KendaroDuong/imu-breakout-board/Breakout_Board/Breakoutboard_Project_log_missing3Dmodels.txt

[('J3', 'C:\\Program Files\\KiCad\\10.0\\share\\kicad\\3dmodels\\Connector_Hirose.3dshapes\\Hirose_DF11-12DP-2DSA_2x06_P2.00mm_Vertical.step')]
