KendaroDuong/imu-breakout-board/Breakout_Board/Schematic_V1.txt

Plotted to 'C:\Users\Nicos.000\Documents\School program\SeniorDesign\imu-breakout-board\Breakout_Board\Breakoutboard_Project.pdf'.

Info: Done.
