KendaroDuong/imu-breakout-board/Breakout_Board/Breakoutboard_Project.pdf

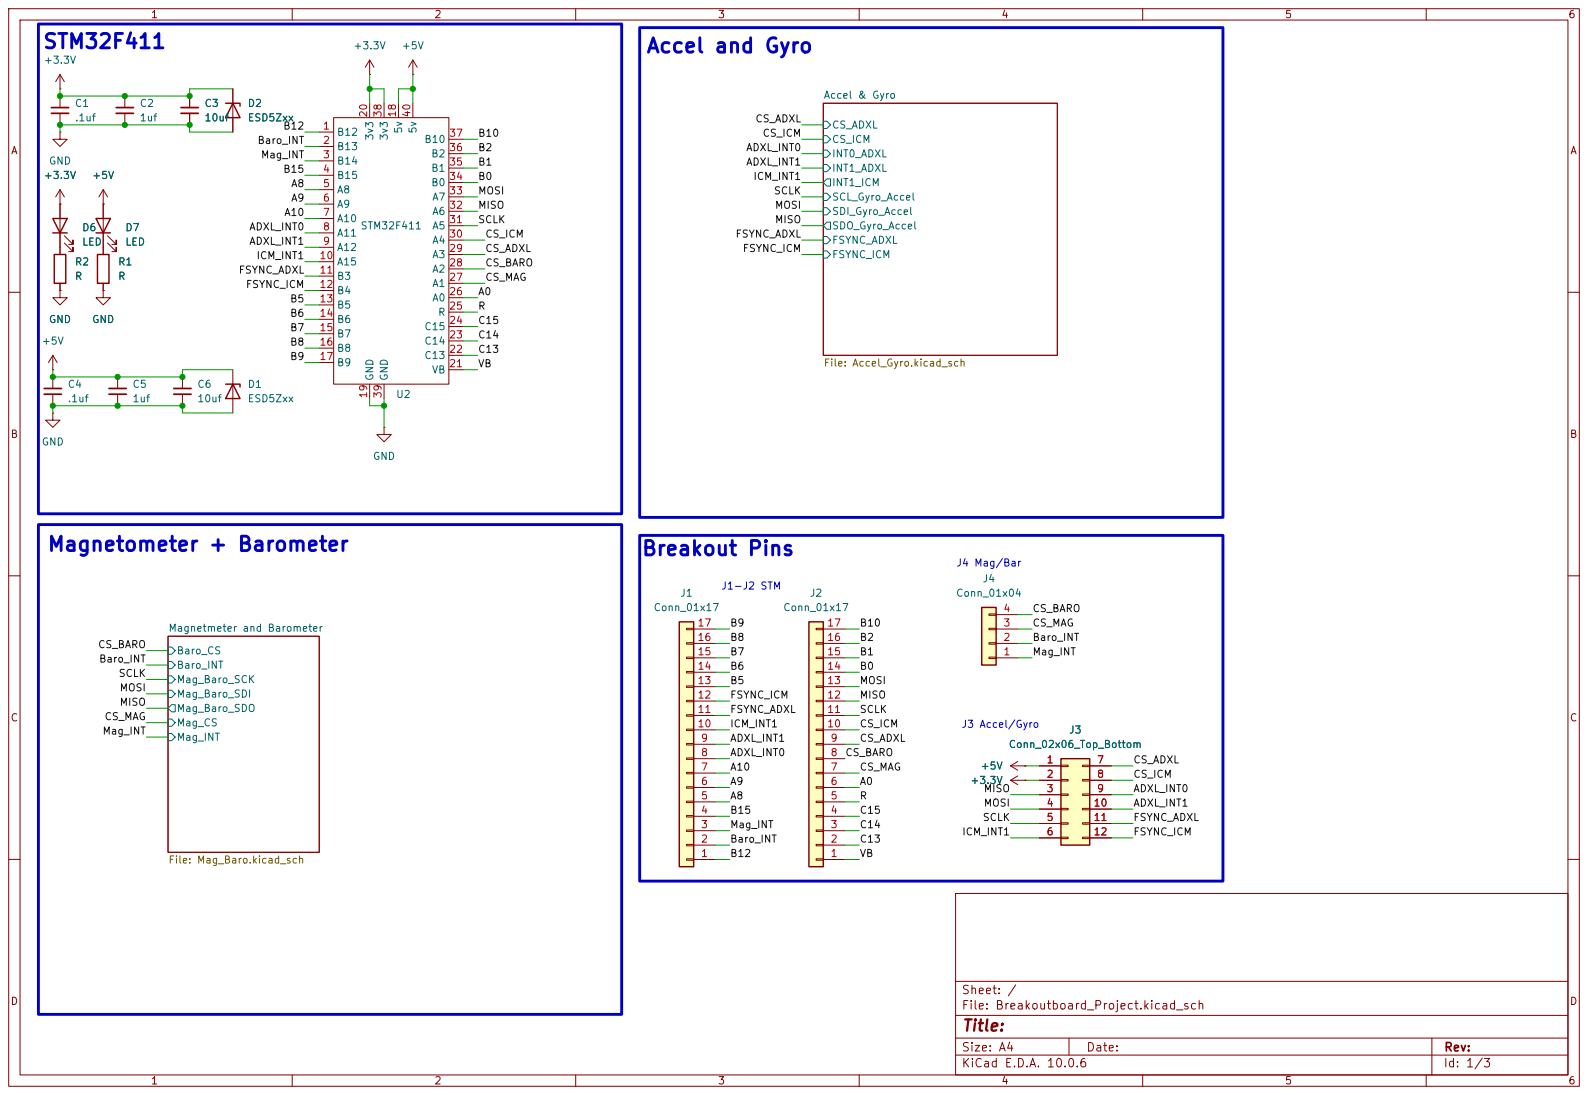
[picture p1: page 1]

Size: A4 | Rev:
KiCad E.D.A. 10.0.6 | Id: 1/3

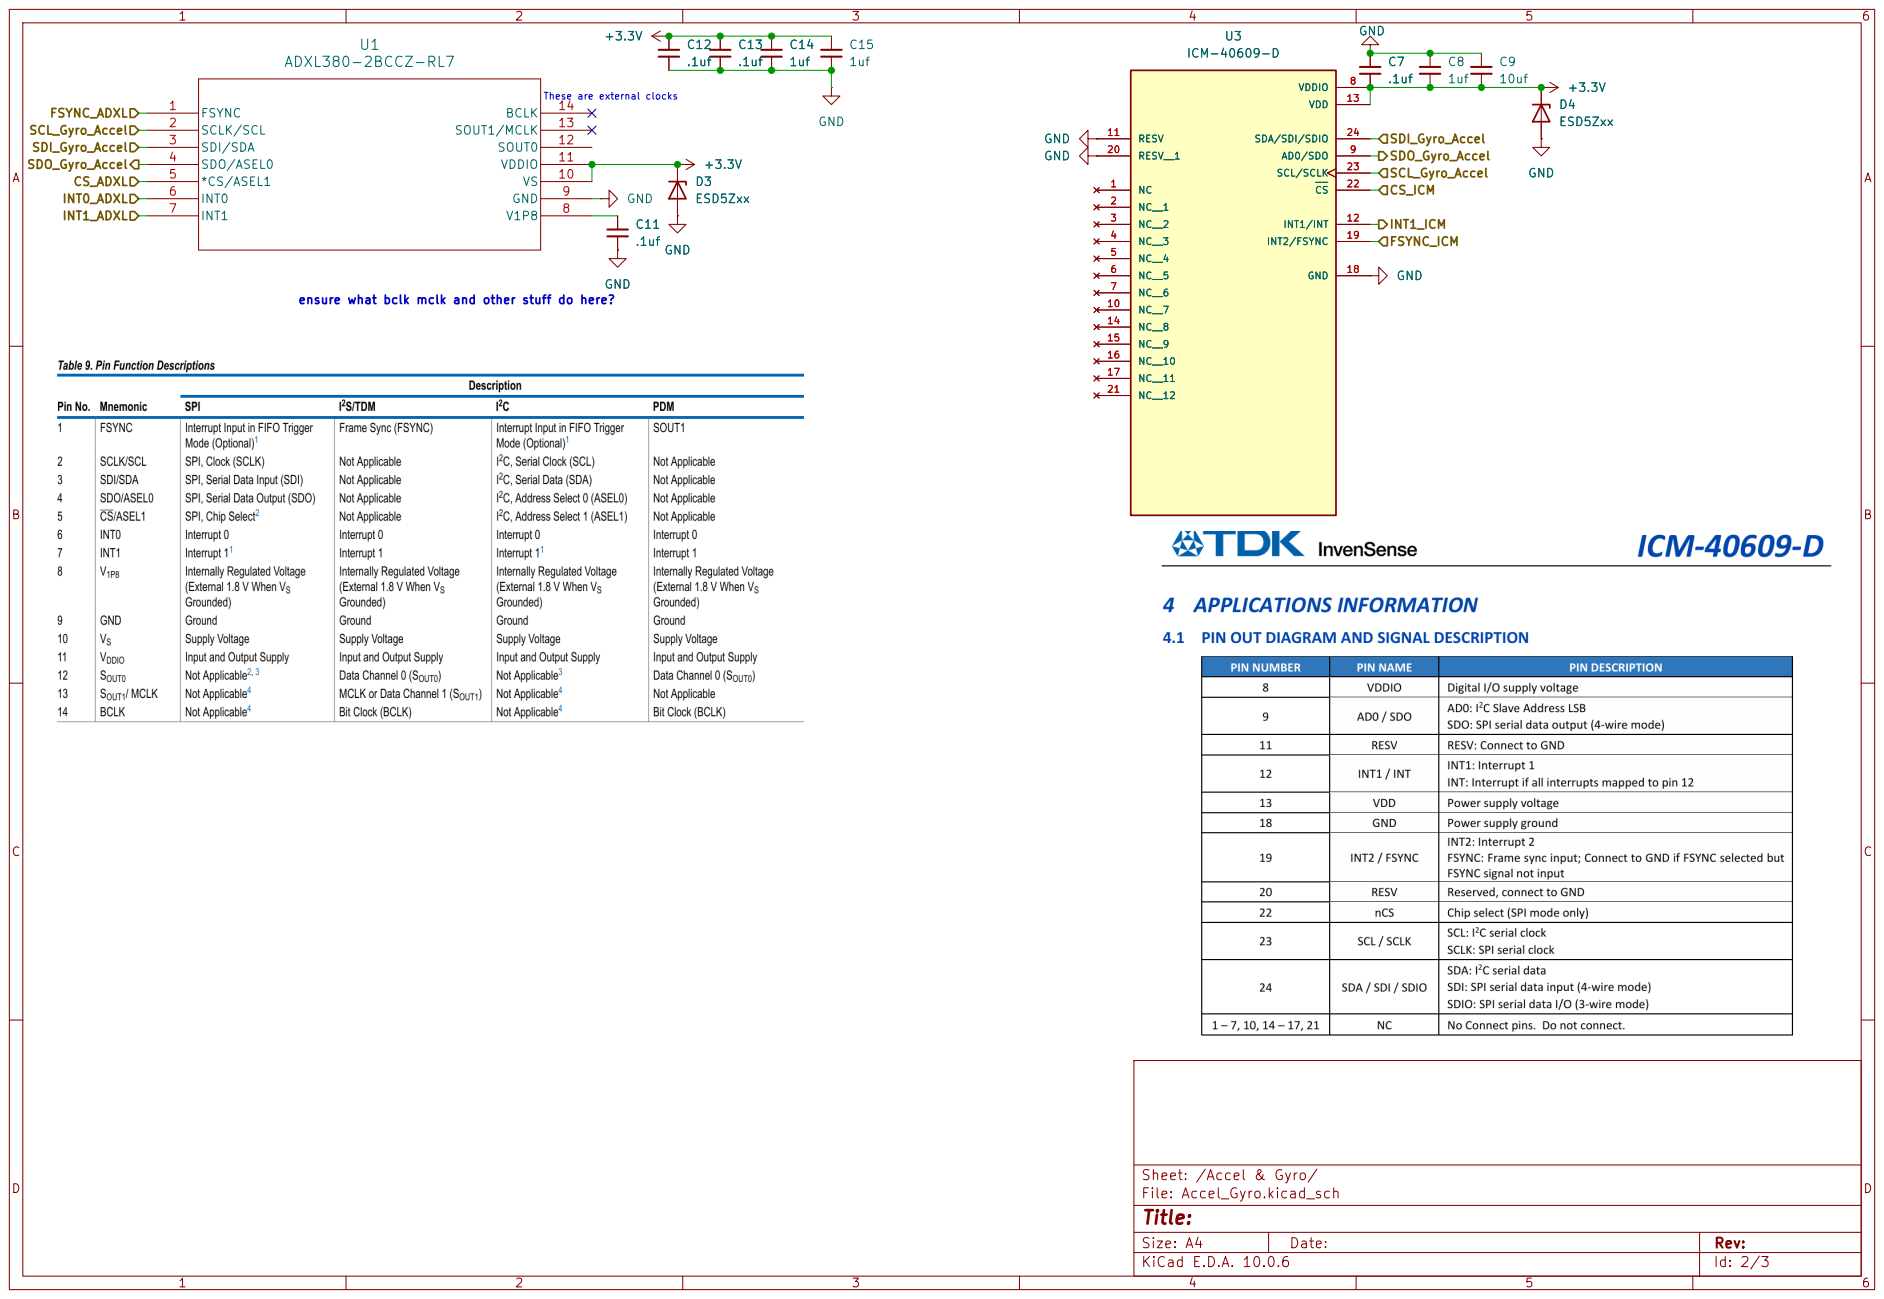
[picture p2: page 2]

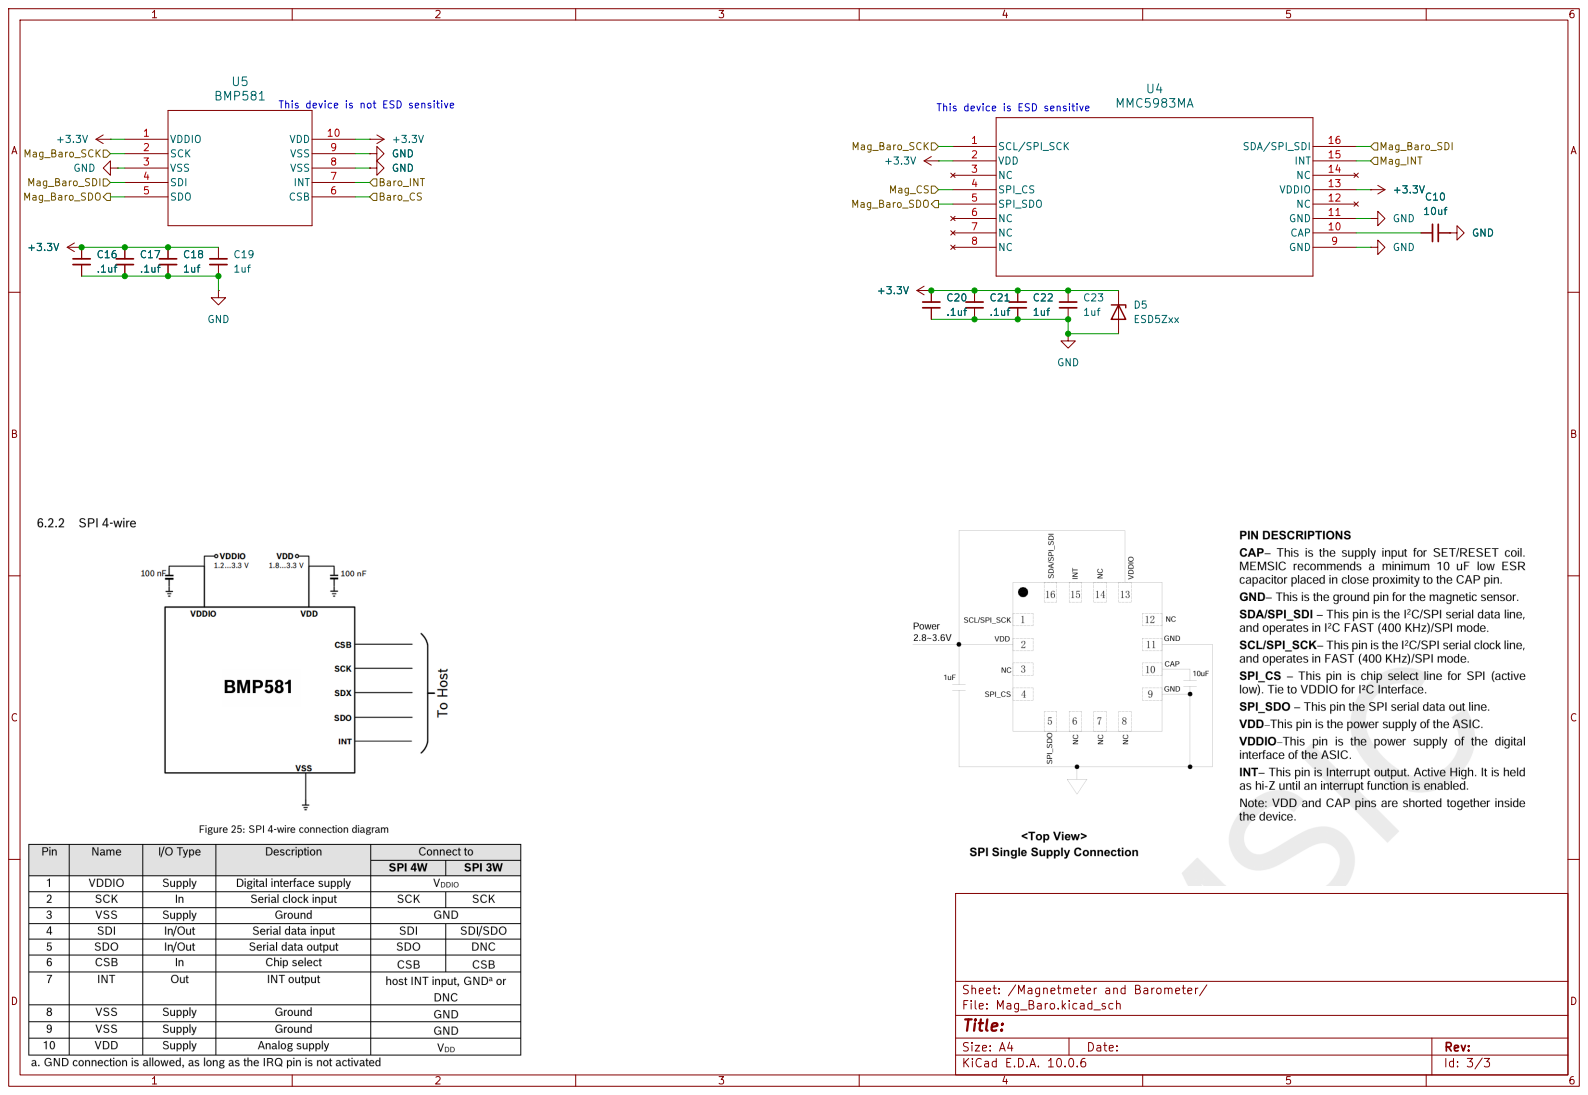
[picture p3: page 3]

Sheet: /Magnetmeter and Barometer/
File: Mag_Baro.kicad_sch
Title:
