KendaroDuong/imu-breakout-board/Breakout_Board/Breakoutboard_Project.kicad_pcb

## KiCad design Breakout_Board/Breakoutboard_Project.kicad_pcb (2026-10-21)

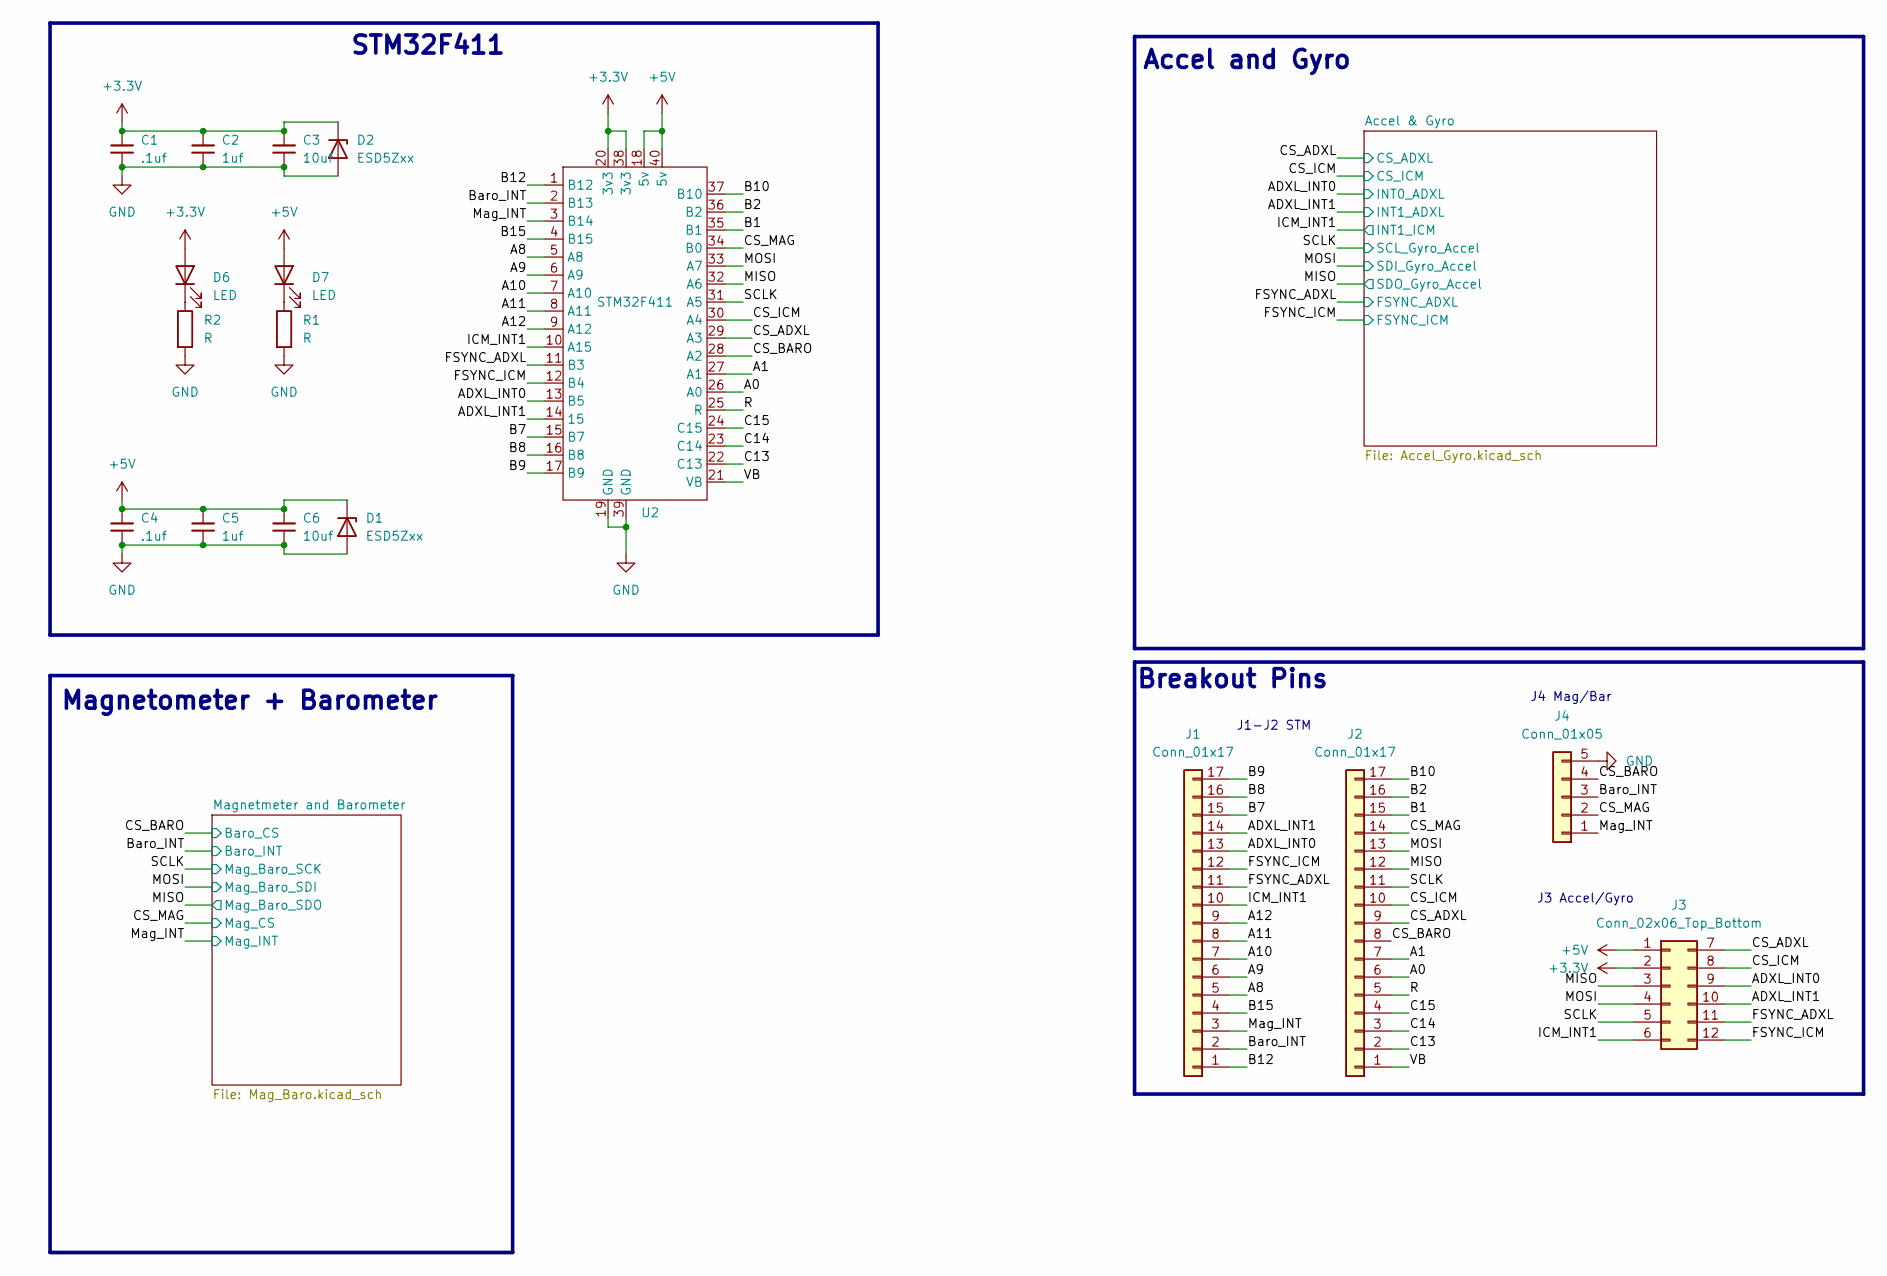
[picture p4: schematic Breakoutboard_Project.kicad_sch]

Parts:
C1, C4: .1uf; C_0805_2012Metric_Pad1.18x1.45mm_HandSolder
C2, C5: 1uf; C_0805_2012Metric_Pad1.18x1.45mm_HandSolder
C3, C6: 10uf; C_0805_2012Metric_Pad1.18x1.45mm_HandSolder
D1, D2: ESD5Zxx; D_SOD-523
D6, D7: LED; LED_0805_2012Metric_Pad1.15x1.40mm_HandSolder
J1, J2: Conn_01x17; PinHeader_1x17_P2.54mm_Vertical
J3: Conn_02x06_Top_Bottom; Hirose_DF11-12DP-2DSA_2x06_P2.00mm_Vertical
J4: Conn_01x05; PinHeader_1x05_P2.54mm_Vertical
R1, R2: R; LED_0805_2012Metric_Pad1.15x1.40mm_HandSolder
U2: STM32F411; BlackpillGeneric

Connections:
+3.3V: C1.1, C2.1, C3.1, D2.1 (K), D6.2 (A), J3.2, U2.20 (3v3), U2.38 (3v3); also elsewhere on the board
+5V: C4.1, C5.1, C6.1, D1.1 (K), D7.2 (A), J3.1, U2.18 (5v), U2.40 (5v)
/A0: J2.6, U2.26 (A0)
/A1: J2.7, U2.27 (A1)
/A8: J1.5, U2.5 (A8)
/A9: J1.6, U2.6 (A9)
/A10: J1.7, U2.7 (A10)
/A11: J1.8, U2.8 (A11)
/A12: J1.9, U2.9 (A12)
/ADXL_INT0: J1.13, J3.9, U2.13 (B5); also elsewhere on the board
/ADXL_INT1: J1.14, J3.10, U2.14 (15); also elsewhere on the board
/B1: J2.15, U2.35 (B1)
/B2: J2.16, U2.36 (B2)
/B7: J1.15, U2.15 (B7)
/B8: J1.16, U2.16 (B8)
/B9: J1.17, U2.17 (B9)
/B10: J2.17, U2.37 (B10)
/B12: J1.1, U2.1 (B12)
/B15: J1.4, U2.4 (B15)
/Baro_INT: J1.2, J4.3, U2.2 (B13); also elsewhere on the board
/C13: J2.2, U2.22 (C13)
/C14: J2.3, U2.23 (C14)
/C15: J2.4, U2.24 (C15)
/CS_ADXL: J2.9, J3.7, U2.29 (A3); also elsewhere on the board
/CS_BARO: J2.8, J4.4, U2.28 (A2); also elsewhere on the board
/CS_ICM: J2.10, J3.8, U2.30 (A4); also elsewhere on the board
/CS_MAG: J2.14, J4.2, U2.34 (B0); also elsewhere on the board
/FSYNC_ADXL: J1.11, J3.11, U2.11 (B3); also elsewhere on the board
/FSYNC_ICM: J1.12, J3.12, U2.12 (B4); also elsewhere on the board
/ICM_INT1: J1.10, J3.6, U2.10 (A15); also elsewhere on the board
/MISO: J2.12, J3.3, U2.32 (A6); also elsewhere on the board
/MOSI: J2.13, J3.4, U2.33 (A7); also elsewhere on the board
/Mag_INT: J1.3, J4.1, U2.3 (B14); also elsewhere on the board
/R: J2.5, U2.25 (R)
/SCLK: J2.11, J3.5, U2.31 (A5); also elsewhere on the board
/VB: J2.1, U2.21 (VB)
GND: C1.2, C2.2, C3.2, C4.2, C5.2, C6.2, D1.2 (A), D2.2 (A), J4.5, R1.2, R2.2, U2.19 (GND), U2.39 (GND); also elsewhere on the board
unnamed: D6.1 (K), R2.1
unnamed: D7.1 (K), R1.1

Notes on the sheet:
Breakout Pins
STM32F411
Magnetometer + Barometer
Accel and Gyro
J1-J2 STM
J4 Mag/Bar
J3 Accel/Gyro

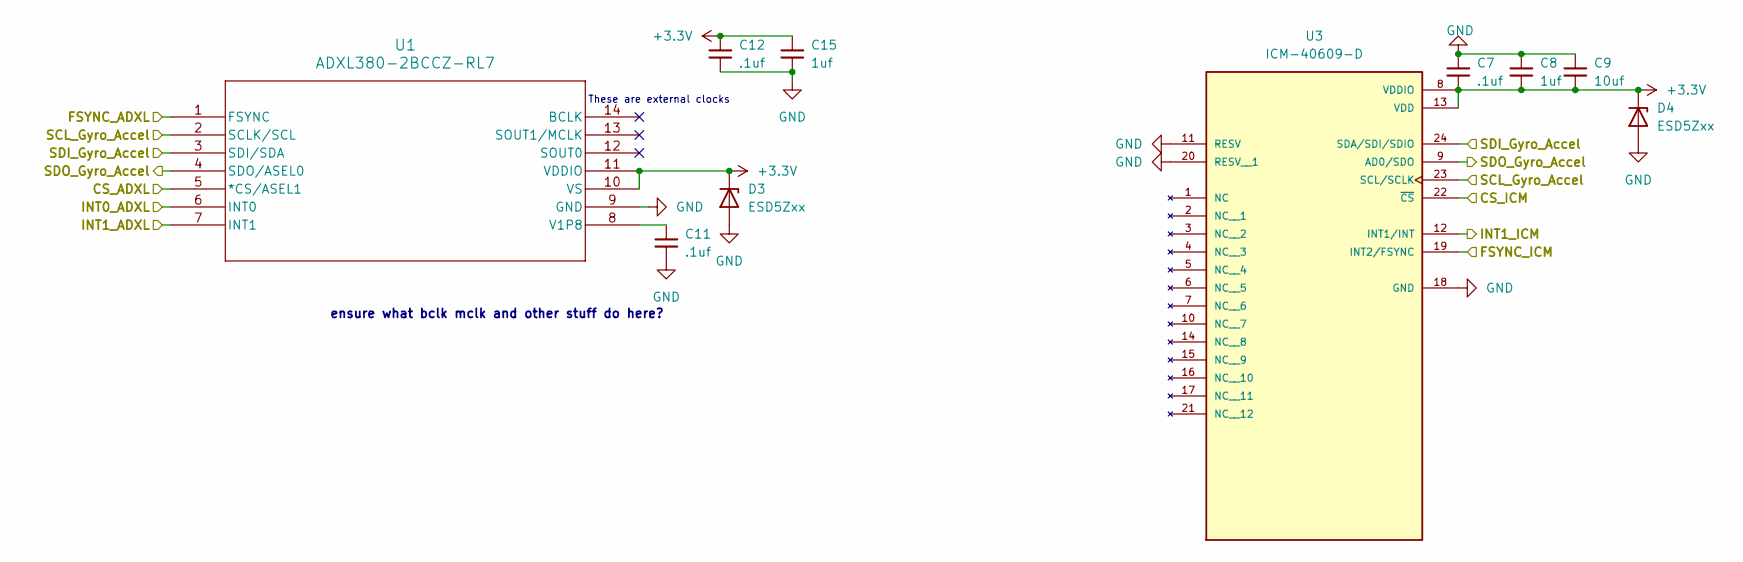
[picture p5: schematic Accel_Gyro.kicad_sch]

Parts:
C7, C11, C12: .1uf; C_0805_2012Metric_Pad1.18x1.45mm_HandSolder
C8, C15: 1uf; C_0805_2012Metric_Pad1.18x1.45mm_HandSolder
C9: 10uf; C_0805_2012Metric_Pad1.18x1.45mm_HandSolder
D3, D4: ESD5Zxx; D_SOD-523
U1: ADXL380-2BCCZ-RL7; CC-14-3_ADI
U3: ICM-40609-D; XDCR_ICM-40609-D; PARTREV 1.2

Connections:
+3.3V: C7.2, C8.2, C9.2, C12.1, C15.1, D3.1 (K), D4.1 (K), U1.10 (VS), U1.11 (VDDIO), U3.8 (VDDIO), U3.13 (VDD); also elsewhere on the board
/ADXL_INT0: U1.6 (INT0); also elsewhere on the board
/ADXL_INT1: U1.7 (INT1); also elsewhere on the board
/CS_ADXL: U1.5 (*CS/ASEL1); also elsewhere on the board
/CS_ICM: U3.22 (~CS); also elsewhere on the board
/FSYNC_ADXL: U1.1 (FSYNC); also elsewhere on the board
/FSYNC_ICM: U3.19 (INT2/FSYNC); also elsewhere on the board
/ICM_INT1: U3.12 (INT1/INT); also elsewhere on the board
/MISO: U1.4 (SDO/ASEL0), U3.9 (AD0/SDO); also elsewhere on the board
/MOSI: U1.3 (SDI/SDA), U3.24 (SDA/SDI/SDIO); also elsewhere on the board
/SCLK: U1.2 (SCLK/SCL), U3.23 (SCL/SCLK); also elsewhere on the board
GND: C7.1, C8.1, C9.1, C11.2, C12.2, C15.2, D3.2 (A), D4.2 (A), U1.9 (GND), U3.11 (RESV), U3.18 (GND), U3.20 (RESV__1); also elsewhere on the board
unnamed: C11.1, U1.8 (V1P8)

Notes on the sheet:
ensure what bclk mclk and other stuff do here?
These are external clocks

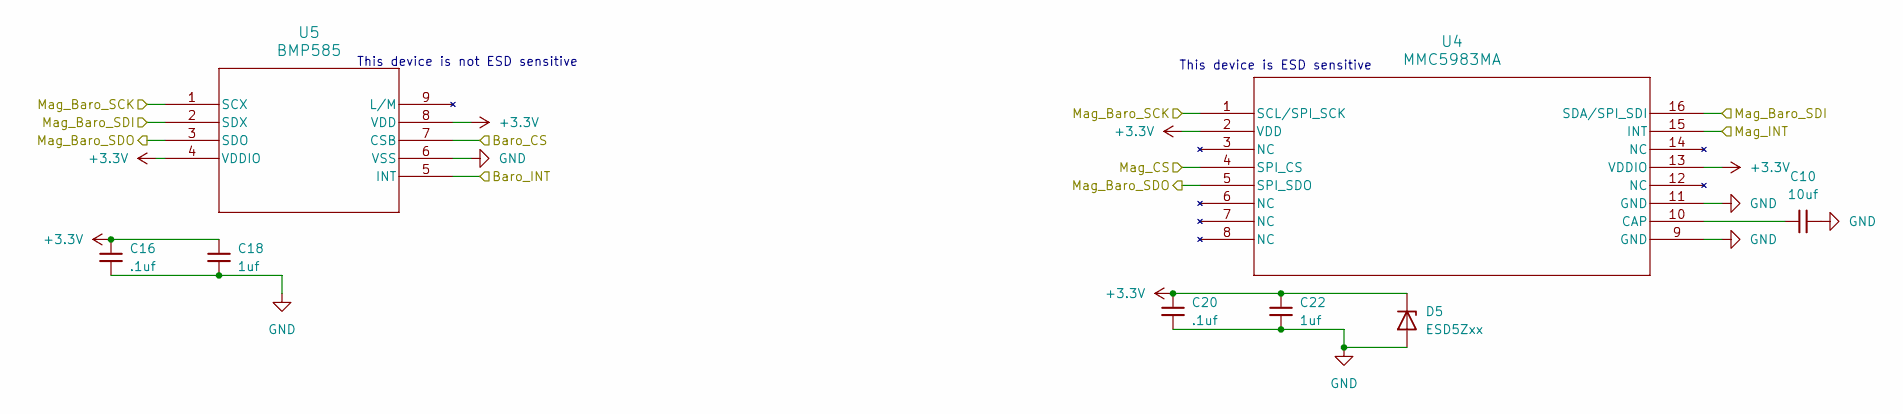
[picture p6: schematic Mag_Baro.kicad_sch]

Parts:
C10: 10uf; C_0805_2012Metric_Pad1.18x1.45mm_HandSolder
C16, C20: .1uf; C_0805_2012Metric_Pad1.18x1.45mm_HandSolder
C18, C22: 1uf; C_0805_2012Metric_Pad1.18x1.45mm_HandSolder
D5: ESD5Zxx; D_SOD-523
U4: MMC5983MA; MMC5983MA_MEM
U5: BMP585; LGA9_BMP585_BOS

Connections:
+3.3V: C16.1, C18.1, C20.1, C22.1, D5.1 (K), U4.2 (VDD), U4.13 (VDDIO), U5.4 (VDDIO), U5.8 (VDD); also elsewhere on the board
/Baro_INT: U5.5 (INT); also elsewhere on the board
/CS_BARO: U5.7 (CSB); also elsewhere on the board
/CS_MAG: U4.4 (SPI_CS); also elsewhere on the board
/MISO: U4.5 (SPI_SDO), U5.3 (SDO); also elsewhere on the board
/MOSI: U4.16 (SDA/SPI_SDI), U5.2 (SDX); also elsewhere on the board
/Mag_INT: U4.15 (INT); also elsewhere on the board
/SCLK: U4.1 (SCL/SPI_SCK), U5.1 (SCX); also elsewhere on the board
GND: C10.2, C16.2, C18.2, C20.2, C22.2, D5.2 (A), U4.9 (GND), U4.11 (GND), U5.6 (VSS); also elsewhere on the board
unnamed: C10.1, U4.10 (CAP)

Notes on the sheet:
This device is not ESD sensitive
This device is ESD sensitive

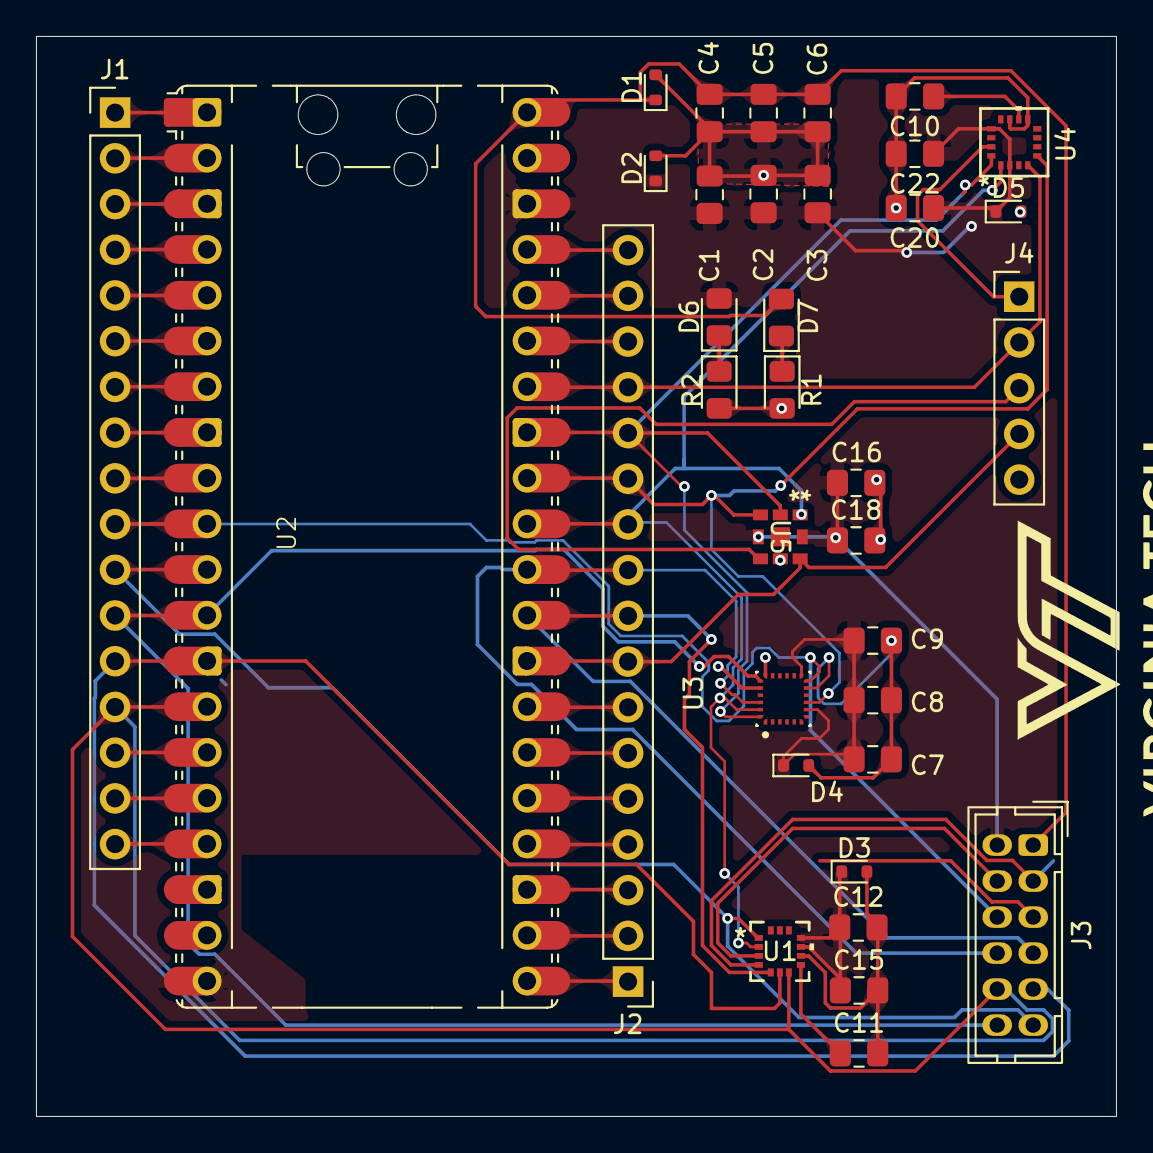
[picture p7: board Breakoutboard_Project.kicad_pcb from above]

Board: 2 copper layers, 60.0 x 60.0 mm, 35 parts (0 on the bottom side), 41 nets.
