KendaroDuong/imu-breakout-board/(commit log)

2026-09-23 Initial commit: IMU sensor breakout board KiCad project
    Includes schematic and PCB with 5 sensors from the trade study
    (ADXL380, ICM-40609-D, IAM-20380, MMC5983MA, BMP581) placed,
    plus reference KiCad documentation.
    [Breakoutboard_Project.kicad_pcb, Breakoutboard_Project.kicad_sch]
2026-09-23 Stop tracking KiCad lock files and editor history artifact
2026-09-25 Added costum footprint
    [Breakoutboard_Project.kicad_pcb, Breakoutboard_Project.kicad_sch]
2026-09-25 Finished STM32 costum symbol and footprint
2026-09-26 added the costum things to main pcb and sch
    [Breakoutboard_Project.kicad_pcb, Breakoutboard_Project.kicad_sch]
2026-09-26 added more organization
    heriarchical sheets yay, added all the compoennts we will be working with and seperated into sheets so we can work on the in parralel easier.
    [Accel_Gyro.kicad_sch, Breakoutboard_Project.kicad_pcb, Breakoutboard_Project.kicad_sch, Mag_Baro.kicad_sch]
2026-09-27 mmm more stuff
    [Accel_Gyro.kicad_sch, Breakoutboard_Project.kicad_sch, Breakouts.kicad_sch]
2026-09-27 changing around some things
    [Accel_Gyro.kicad_sch, Breakoutboard_Project.kicad_pcb, Breakouts.kicad_sch]
2026-09-27 completed mag and baromet
    fInished mag and barometer connections and connected to stm32f411, I just need the breakout pins to be done now.
    [Breakoutboard_Project.kicad_sch, Mag_Baro.kicad_sch]
2026-09-29 ready for breakout
    Fixed up some work, now its ready for breakouts before final PCB layout
    [Breakoutboard_Project.kicad_pcb, Breakoutboard_Project.kicad_sch, Mag_Baro.kicad_sch]
2026-09-30 Add breakout pin headers (J1-J4) for probing all sensor/MCU signals
    [Breakoutboard_Project.kicad_sch]
2026-09-30 some layout
    [Breakoutboard_Project.kicad_pcb, Breakoutboard_Project.kicad_sch]
2026-10-06 Preliminary decoupling cap layout and PCB updates
    [Breakoutboard_Project.kicad_pcb]
2026-10-06 ready for routing
    [Accel_Gyro.kicad_sch, Breakoutboard_Project.kicad_pcb, Breakoutboard_Project.kicad_sch, Mag_Baro.kicad_sch]
2026-10-09 Swap BMP581 for BMP585, move ADXL interrupts to PB5/PB6, add J4 GND, clean up library pin types
    - Add BMP585 library (symbol + LGA9 footprint) and replace U5
    - Move ADXL_INT0/INT1 off PA11/PA12 (USB pins) to PB5/PB6
    - J4 now 5-pin with GND
    - Set GND/VSS pins to power input in ADXL380, MMC5983MA, BMP585 symbols
    - Add library prefix to ADXL380 symbol footprint field
    [Accel_Gyro.kicad_sch, Breakoutboard_Project.kicad_pcb, Breakoutboard_Project.kicad_sch, Mag_Baro.kicad_sch]
2026-10-09 Save PCB with BMP585 (U5) and 5-pin J4 footprints
    [Breakoutboard_Project.kicad_pcb]
2026-10-09 Detailed change log: BMP585 swap, ADXL interrupt move, J4 GND, symbol cleanup
    Summary of the work since "ready for routing" (8510be7); this commit adds
    documentation only (commits 49f525f and 127c527 hold the file changes).
    Barometer: BMP581 -> BMP585 (BMP581 was sold out)
    - Added Libraries/BMP585 (Ultra Librarian KiCad v6+ export): symbol plus
    LGA9_BMP585_BOS / -L / -M footprints. Registered as "BMP585" in
    sym-lib-table and fp-lib-table.
    - The BMP585 is a different package (8-pin metal-lid LGA, 3.25 x 3.25 mm, plus
    a laser-mark pad 9) so it is not a drop-in swap. Replaced U5 with Change
    Symbols, rewired by the BMP585 pin table, footprint
    BMP585:LGA9_BMP585_BOS.
    - U5 nets: 1 SCX=S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
2026-10-21 Route ICM/ADXL SPI, chip-select, interrupt and FSYNC nets; fix U3 footprint keepout
    Routing (482 track segments, up from 219; 32 vias, up from 18)
    - SPI bus (SCLK, MOSI, MISO) to the sensors
    - CS_ICM, CS_ADXL, CS_BARO chip selects
    - ICM_INT1, ADXL_INT0, ADXL_INT1 interrupts and FSYNC_ICM, FSYNC_ADXL
    - More +3.3V and GND connections
    - Unrouted connections down to 15
    U3 (ICM-40609-D) footprint
    - Deleted the two SnapMagic keepout rule areas covering the package body.
    They blocked tracks into the pads and caused the 8 "items not allowed"
    errors. The datasheet does not call for them. (Board copy only; the
    library footprint still has them.)
    Design rules
    - Default net class clearance 0.2 ->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
